Yoshida256k/maglev/リニアモーターカー仕様書.md

# リニアモーターカー仕様書

- 版：v0.3（2026-10-25）
- 用途：プレ卒業研究で製作する卓上リニアモーターカー（周回コース）の駆動システム
- コンセプト：**浮いてるミニ四駆**（永久磁石の反発で浮上し、左右の透明壁を2段ローラーでなぞって走る。車輪なし）
- 本書の使い方：本書をもとにファームウェアを作成する（生成 AI の利用を含む）。**【要確定】** の値は未決定。コードではデフォルト値で実装し、すべてパラメータ（定数または設定コマンド）として変更できるようにすること。
- CADモデル：`maglev_course.step`（生成スクリプト `maglev_course_model.py`）。寸法は本書と一致させている
- v0.3 の主な変更：
  - 車輪をやめ、永久磁石の反発で浮上する方式に変更（床に浮上磁石2列、台車に8個）
  - 内側は透明板、外側は透明シート＋透明なコイル枠。台車は前後・内外の2段ローラー（計8個）
  - 位置検出をホールセンサーの個別読み出し（74HC165）＋台車5極（S N S N S）に変更し、電源投入時から絶対位置がわかるようにした。原点センサーとホーミングを廃止し、ティーチングと位置決め制御を追加
  - ホールセンサーをユニポーラ・スイッチ型（OH44E / A3144）に指定。49E はリニア出力なので使用不可
  - 磁石の個数と費用、浮上方式の注意点を追加

---

## 0. 用語

| 用語 | 意味 |
|---|---|
| 区間（セクション） | 円周コースを等分した、個別に通電を切り替えられるコイル群の単位 |
| 母線 | インバーター出力 U・V・W をコース沿いに通した共通配線 |
| SD | ゲートドライバーのシャットダウン入力（負論理）。Low でインバーター停止 |
| m | 変調率（振幅）。0〜0.8 |
| f1 | 基本波周波数 [Hz] |
| fc | キャリア周波数 [Hz] |
| τ | 台車の駆動磁石の極ピッチ（N→S の間隔）。電気角 360° = 2τ。**中心角 4.5°（約 37.5 mm）** |
| θe | 電気角 |
| 台車位置 x | 台車の駆動磁石列「先頭」のコース上の位置。内部では中心角 [deg] または弧長 [mm] で扱う（1周 = 360° = 3000 mm） |
| セル | ホールセンサーのパターンで区別できる最小の位置単位。電気角 60° = 中心角 1.5°（約 12.5 mm） |

---

## 1. システム概要

- 方式：**地上一次式リニア同期モーター（LSM）＋永久磁石の反発による浮上**
  - 推進：外側のコイル（3相・空芯）と、台車の外側にある駆動磁石（5極）
  - 浮上：床の浮上磁石（N極上向き）と台車底面の浮上磁石（N極下向き）の反発
  - 案内：内側の透明板と外側の透明シートを、台車の2段ローラーでなぞる
- コース：**円周 3.0 m の周回コース**（コイル中心の半径 約 477.5 mm）。走行路の幅 110 mm
- 目標最高速度：**30 km/h（8.33 m/s）**。このときの基本波周波数は約 111 Hz
- **コース上のどこでも停止・発進でき、任意の位置まで運べること**
- 駆動構成：3相インバーター1台 → 母線（U・V・W）→ 区間ごとのリレー → 各区間のコイル
- 位置検出：ホールIC（ユニポーラ・スイッチ型）61個を個別に読み出し、パターンから絶対位置を求める
- 保護：ハードウェア過電流保護（SD を直接 Low）、ヒューズ、非常停止

```
 DC電源 ─ヒューズ─┬─ 3相インバーター(IGBT×6) ─ U/V/W 母線 ──┬── リレー1 ── 区間1 コイル(Y結線)
                  │        ↑ PWM, SD(共通)                  ├── ...
                  │   マイコン ←── HALL_A/B/C（ダイオードOR、割り込み）
                  │        ↑    ←── 74HC165×8（全ホールの個別読み出し、SPI）
                  │                                          └── リレー10 ── 区間10 コイル
                  └─ シャント → 増幅 → コンパレーター ──→ SD 強制Low ＋ マイコン割り込み
```

---

## 2. ハードウェア前提

### 2.1 インバーター・電源

- スイッチング素子：IGBT（各相ハーフブリッジ×3）
- ゲートドライバー：**IR2104**（IR2302 とピン互換。どちらでも可）
  - ピン配置：1:VCC、2:IN、3:/SD、4:COM、5:LO、6:VS、7:HO、8:VB
  - 1入力・デッドタイム内蔵（約 0.5 µs）。入力は 3.3 V ロジック対応
  - VCC は 15 V（IGBT のゲート電圧）
  - **IR2104 はハイサイド（VBS）の低電圧ロックアウトがない**ため、ファームウェアで次を守る
    - 起動時：SD を High にした直後、全相のローサイドを `T_BOOTSTRAP`（デフォルト 5 ms）ON にしてブートストラップを充電してから PWM を開始する
    - デューティを 100% に張り付かせない（m ≤ 0.8 なので最大 90%）
  - 出力形式を切り替えられること：`DRIVER_TYPE = IR2104 | HIN_LIN`（`IR2104` は IR2302 でも同じ）
- /SD：負論理。**全相共通で1本の GPIO（`SD_GPIO`）**に接続
  - 電源投入時・リセット時・FAULT 時は Low（停止）
  - 過電流コンパレーターと非常停止スイッチの出力も、同じ SD ラインをワイヤードORで Low にできる構成とする
- DCバス電圧 `VDC`：**24 V**（速度に余裕が欲しい場合も 30 V まで。リレー接点定格 DC 30 V、TVS 50 V の範囲内とするため）
- 電源：**絶縁された電源（市販の 24 V スイッチング電源、または絶縁トランス＋整流）**を使う
  - **スライダック＋整流は使用禁止**（単巻変圧器で商用電源と絶縁されておらず、出力が大地に対して 100 V で浮く。感電の危険があり、PC を USB 接続すると短絡する）
- DCバスに電解コンデンサー（耐圧 50 V 以上）

### 2.2 コース構造

寸法は**中心角で設計する**（部品ごとに半径が違うため、長さで揃えるとずれる）。高さは床面（ベース上面）を z = 0 とする。

| 部品 | 半径 R [mm] | 高さ z [mm] | 材料・備考 |
|---|---|---|---|
| ベース | 337〜500 | −8〜0 | 黒の板 |
| 床の浮上磁石（2列） | 392.5 と 432.5 を中心に幅 10〜12 | 0〜5 | ネオジム 20×10×5、**N極上向き**、隙間なく並べて溝に接着 |
| 内側の透明板 | 360.5〜362.5（走行面 362.5） | 0〜100 | PC または PETG を曲げて使用 |
| 外側の透明シート | 472.5〜473.5（走行面 472.5） | 0〜110 | PC 1 mm を曲げ、コイル面に密着させる |
| コイル | 473.5〜481.5 | 17〜67（中心 42） | 2.3節 |
| ホールセンサー列 | 473.5〜476.5 | 84（中心） | コイル上端から 17 mm 上。2.5節 |
| コイル枠・背板 | 481.5〜485.5 | 0〜110 | **透明**。PC 板（4 mm 程度）を曲げて使用 |
| コイル枠・上下の縁 | 473.5〜481.5 | 0〜10、102〜110 | **透明**。アクリル板のレーザーカット（平らな円弧リング） |

- コイル枠は10区間（各 36°）に分けて作る
- 遠心力は「ローラー → 外側シート → コイル → 背板」の順に伝わる。背板がたわむと磁石とコイルの隙間が広がるので、背板を厚めにするか、外側に透明アクリルの縦リブを入れる
- ホールセンサーの基板（センサー台）は透明にできないので、細い基板を透明アクリルの棚に載せる形を推奨

### 2.3 コイル・駆動磁石

- 配置：**3：4（コイル3個：磁極4個）**の集中巻。コイルは全部同じ向きに巻き、**U V W U V W …** の順に並べる
  - コイル間隔：**6°**（コイル中心の半径で約 50 mm）
  - 磁極ピッチ τ：**4.5°**（約 37.5 mm）
  - 繰り返し単位（U・V・W 1組）：18°（約 150 mm）
- コイル総数：**60個**（各相 20個）
- コイル寸法：外径 50 mm、内径 20 mm、厚さ 8 mm（空芯）
- 巻線：**UEW 0.9 mm、80回**（手巻き、占積率 約 0.5）
  - 1個あたりの線長 約 8.8 m、合計 約 530 m（予備込み 600 m、銅 約 3.4 kg）
  - 1個あたり R ≈ 0.24 Ω、L ≈ 190 µH（計算値。**巻いたら LCR メーターで実測する**）
- 巻数の根拠：24 V・m = 0.8 で使える相電圧ピーク 9.6 V に対し、30 km/h で必要な電圧が約 0.1 × N [V]（逆起電力が大部分）。N ≤ 96 のうち余裕を見て 80回
- 推力の見積もり：コイル1個あたり 200 AT（2.5 A × 80回）で約 3 N（±50%。試作で確認する）
- 駆動磁石（台車側）：ネオジム、**5極（S N S N S）、中心角 22.5°（約 187.5 mm）**
  - 1極 = 30×20×10 mm を縦に2個重ねて、幅 30 × 高さ 40 × 厚さ 10 mm 相当
  - 半径 458.5〜468.5、高さ 22〜62
  - **磁石とコイル面の隙間 5 mm**（シート内面までのすき間 4 mm ＋ シート 1 mm）
  - 両端を S 極にするのは、ホールセンサーのパターンで位置を一意に決めるため（2.5節）
  - 取付部（外側ポッド）はコースと同じ半径の円弧状にする
- **コイルを2〜3個試作して逆起電力を測ってから量産する**（6章）

### 2.4 浮上と案内

- 浮上：床の浮上磁石（N極上向き、2列）と台車底面の浮上磁石（N極下向き、20×10×5 mm を2列×4個）の反発で浮かせる
- 浮上高さ：**約 6 mm**（床磁石の上面〜台車磁石の下面）【試作で確認】
- **反発浮上は横方向と横転方向が原理的に不安定**（アーンショーの定理）。台車は常にどちらかの壁に押し付けられるので、ローラーは**常に壁を擦りながら走る**前提で設計する
- ローラー：**φ13 の2段ローラー**（ミニ四駆と同じ構成。1本の軸に上下2個）
  - 前後 × 内外 × 上下 = 8個。高さ 22〜28 と 66〜72
  - **ベアリング入り**を使う（常時接触するため）
  - ローラーと壁のすき間：片側 0.3 mm（設計値）
- 台車の質量：磁石込みで約 0.5 kg の見込み【要確定】
- 台車の高さ：約 92 mm（ホールセンサー列に合わせて外側ポッドが高くなるため）
- 床の浮上磁石は、**隙間があると走行中に上下に揺れる**ので詰めて並べる。同極どうしは強く反発するので、溝に接着剤で固定しながら並べる
- 床磁石の磁界が強いため、床面にホールセンサーは置かない

### 2.5 区間（セクション）

- 分割数 `N_SEC`：**10**
- 区間長：中心角 36°（約 300 mm）= 繰り返し単位 2組。1区間に**コイル6個（各相2個）**
- 各区間のコイルは **Y結線**。同じ相の2個は直列。中性点は区間内で閉じ、他区間と共有しない
- 1区間・1相（コイル2個直列）の定数：**R ≈ 0.48 Ω、L ≈ 0.38 mH**（実測値に置き換える）
- 区間スイッチ：**2極リレー 1個／区間**。U相とV相を開閉し、W相は常時接続
  - 接点定格：**DC 30 V・10 A 以上**（AC定格は参考にしない）
  - 駆動：ULN2803 などのトランジスタアレイ（逆起電力吸収ダイオード内蔵品）
  - 各接点間に **双方向TVS（50 V）** を接続
  - 動作時間 `T_RELAY_ON_MAX`：デフォルト 15 ms（**購入したリレーをオシロで実測した最大値に置き換える**）
  - 復帰時間 `T_RELAY_OFF_MAX`：デフォルト 5 ms（同上）
- 代替案（MOSFET による双方向スイッチ）は付録A

### 2.6 位置センサー（ホールIC）

- 種類：**ユニポーラ・スイッチ型**（S極で ON、それ以外は OFF）、**オープンコレクタ出力**
  - 推奨：**OH44E または A3144**
  - 電源は **5 V**（4.5 V 以上が必要。3.3 V では動かない）。出力のプルアップは **3.3 V** に接続する
  - **ラッチ型は使用不可**。格安品には型番どおりでない品が混じるので、届いたら全数を「S極でON・離すとOFF」で選別する
  - **49E（SS49E・OH49E）はリニア（アナログ）出力なので使用不可**
- 配置：
  - 3個1組（A・B・C）を **電気角 120° 間隔（中心角 3°、約 25 mm）** で並べる
  - 組の間隔：**中心角 18°（約 150 mm）**、20組。組の間隔は 2τ（9°）の整数倍とする
  - 高さはコイル上端から 17 mm 上（z = 84）。コイルの磁界による誤動作を避けるため
  - 台車側には、センサー列の高さに駆動磁石と同じ並び（S N S N S）の**センサー用小磁石**（10×10×5 mm）を付ける
- 必要数：**60個**（20組 × 3）＋予備
- 読み出し：
  - **個別読み出し**：60個の出力をそれぞれ **74HC165 × 8個**のデイジーチェーンに入れ、SPI で一度に読む（64 ビット）
  - **割り込み用の A・B・C**：各センサーの出力から**ショットキーダイオード（BAT54 等）経由で OR** を取り、`HALL_A`、`HALL_B`、`HALL_C` の3本にまとめる（アクティブLow）
- ノイズ対策：
  - プルアップ抵抗とRCフィルター（1 kΩ＋1 nF 程度）はマイコンの近くに置く
  - シュミットトリガー（74HC14 など）を通す
  - 信号線はインバーター・コイルの配線から離し、できればツイストペアにする

---

## 3. ファームウェア要件

### 3.1 マイコン

- 型番：【要確定】（既存の信号生成機能を拡張する）
- 必要なリソース：
  - 3相相補 PWM を出せるタイマー 1個（センターアラインド、デッドタイム挿入可能）
  - GPIO 割り込み入力 4本（`HALL_A/B/C`、`OC_FAULT_GPIO`）
  - SPI 1ch（74HC165 の読み出し用。ラッチ用 GPIO 1本）
  - リレー駆動 GPIO：10本（足りなければシフトレジスタ経由）
  - `SD_GPIO` 出力 1本
  - ADC 1ch（任意）
  - UART 1ch
  - 1 kHz の周期処理用タイマー
  - ティーチングで作った位置表を保存する Flash 領域
  - あれば：タイマーのホールセンサーインターフェース機能（エッジ時刻のハードウェアキャプチャ）

### 3.2 PWM 信号生成

- 正弦波：**256点以上のテーブル参照**（推奨 1024 点）。32 bit 位相アキュムレーター（DDS 方式）で読み出す
- 比較方式：三角波比較（センターアラインド PWM）
- デューティ：`duty = 0.5 + 0.5 × m × sin(θ)`
- 3相：U・V・W は 120° ずつ位相をずらす
- 単相：**ユニポーラ変調**（2レグ。レグ1 = +m·sin θ、レグ2 = −m·sin θ）
- デューティの更新：キャリア周期ごとの割り込み（負荷が重ければ2周期ごと）
- 起動時：ブートストラップ充電（2.1節）を行ってから PWM を開始する
- パラメータ範囲：

| パラメータ | 範囲 | 制約 |
|---|---|---|
| fc | 10〜150 kHz | IGBT 使用時は上限 `FC_MAX_IGBT = 20 kHz` |
| f1 | 1 Hz〜3 kHz | **fc ≥ 20 × f1 を満たさない設定は拒否**し、エラーを返す |
| m | 0〜0.8 | 0.8 を超える値は 0.8 に制限 |
| デッドタイム | `DEADTIME_NS`（デフォルト 1000 ns） | `HIN_LIN` モードで付加。`IR2104` モードでは IC 内蔵分（約 0.5 µs）のみ（追加も設定可） |

- 走行時の基本波周波数：f1 = v / (2τ)。30 km/h で約 111 Hz（fc = 20 kHz との比は約 180）
- 注意：fc = 150 kHz・タイマークロック 144 MHz・センターアラインドの場合、PWM 分解能は約 9 bit まで落ちる

### 3.3 V/f 制限（低周波での過電流防止）

コイルのインピーダンスから、周波数ごとの振幅上限を計算する。**停止中に制限がないと 9.6 V ÷ 0.48 Ω = 20 A 流れるので必須。**

```c
// 1区間・1相（コイル2個直列）あたりの定数（LCRメーターで実測した値に置き換える）
#define R_COIL      0.48f     // [Ω]
#define L_COIL      0.38e-3f  // [H]
#define I_COIL_MAX  2.5f      // 1区間あたりの許容ピーク電流 [A]
#define M_ABS       0.8f
// V_GAIN：3相 = VDC/2、単相ユニポーラ = VDC

float m_limit(float f) {
    float x = 2.0f * PI * f * L_COIL;
    float m = I_COIL_MAX * sqrtf(R_COIL*R_COIL + x*x) / V_GAIN;
    return (m > M_ABS) ? M_ABS : m;
}
```

- この式は逆起電力を無視しているので、走行中は安全側（実際の電流は小さくなる）
- 区間は母線に**並列**につながるので、インバーターの電流は「同時ON区間数 × 1区間の電流」になる
  - 追加条件：`N_ON × I_COIL_MAX ≤ I_INV_MAX`。満たせない場合は m をさらに下げる
- 直線的な V/f（ブースト付き）は途中で許容電流を超えるので使わない。上式をそのまま計算する
- 実行タイミング：パラメータ設定時に目標値をクリップし、1 kHz の周期処理で毎回 `m_now ≤ m_limit(f_now)` を強制する
- ランプ処理：f と m に変化率の制限をかける（`RAMP_F_HZ_PER_S`、`RAMP_M_PER_S`）
  - 周波数を下げるとき：**m を先に下げてから** f を下げる
  - 周波数を上げるとき：**f を先に上げてから** m を上げる

### 3.4 位置・速度の検出（絶対位置）

**原理**
- 台車の磁石が両端 S 極の5極なので、60個のホールセンサーの ON/OFF パターンは**コース1周のどの位置でも異なる**（セル単位 = 中心角 1.5°、約 12.5 mm で一意。計算で確認済み）
- したがって、**電源投入直後に全センサーを読めば位置がわかる**。原点センサーとホーミングは不要

**位置表（ティーチングで作る）**
- 理論値ではなく実測で作る（センサーの取り付け誤差を吸収するため）
- `TEACH` コマンドで開始。台車を手でゆっくり1周させ、74HC165 で読んだ 60 ビットのパターンと、その時点の位置カウント（A・B・C のエッジ数）を記録する
- 1周したら「パターン → セル番号（0〜239）」の表を Flash に保存する
- 表にないパターンが出たら異常とする

**走行中の位置**
- 細かい位置：`HALL_A/B/C` の両エッジで割り込みを入れ、3ビットの状態から電気角 60° 刻みの区間（0〜5）を求め、前回との差（±1）で位置カウントを増減する
  - 状態 000 と 111 は異常
  - ±1 以外の飛びは異常としてカウント（`hall_err_count`）
  - 前回のエッジから `HALL_MIN_INTERVAL_US`（デフォルト 300 µs）未満のエッジはノイズとして捨てる（30 km/h でもエッジ間隔は約 1.5 ms）
  - エッジ間は、エッジ間隔から求めた速度で補間する
- 絶対位置の照合：1 kHz の制御周期ごとに 74HC165 で全センサーを読み、表から求めたセルと位置カウントを比べる
  - 1セル以内のずれ：カウントを表の値に合わせて補正する
  - 2セル以上のずれ、または表にないパターン：FAULT
- 速度 v：直近のエッジ間隔から計算。`T_HALL_TIMEOUT`（デフォルト 200 ms）エッジがなければ v = 0
- 状態表（3ビット → 区間）の並びは、センサーの取り付け順と磁石の向きで変わる。ティーチング時に実測の順番から決める

**故障の検出**
- `hall_err_count` が `HALL_ERR_MAX`（デフォルト 10 回 / 1 秒）を超えたら FAULT
- `HALLDIAG` コマンド：全センサーの ON/OFF を一覧表示する（どのセンサーが壊れたかの特定用）

### 3.5 駆動モード

| モード | 内容 | 用途 |
|---|---|---|
| `OPENLOOP_VF` | f1 の指令から電気角を積分し、V/f 制限付きで出力 | 試験、低速 |
| `HALL_SYNC` | ホール信号で電気角を補正して出力（ブラシレスDCモーターと同じ原理） | **本番の走行** |
| `SINGLE_PHASE` | 単相ユニポーラ、正弦波 | パワースピーカー等の試験 |
| `AUDIO` | 単相ユニポーラ、音声データを変調波にする | パワースピーカー |

`HALL_SYNC` の詳細：
- 出力電圧の位相 = θe ＋ `THETA_OFFSET` ＋ `THETA_LEAD`
  - `THETA_OFFSET`：設置後に校正する（デフォルト 90°）
  - `THETA_LEAD`：速度に応じた進角（デフォルト 0°）
- 低速（エッジ間隔 > `T_HALL_TIMEOUT`）では補間せず、その 60° 区間の中央の角度を使う
- 推力は m で指令する（V/f 制限と電流制限の範囲内）
- 発進：静止時は現在のホール状態から位相を決め、m を 0 から徐々に上げる
- 速度制御：目標速度 `v_ref` に対して PI 制御で m を決める
- 走行方向：`DIR = FWD | REV`

### 3.6 位置決め（任意の位置まで運ぶ）

- `GOTO <位置 mm>` で目標位置を指定する。進む方向は近いほう（`DIR` 指定があればそれに従う）
- 速度の指令は台形パターン（加速 → 一定速 → 減速）。加速度 `ACC_MAX`、最高速度 `V_MAX` で作る
- 最後は位置の偏差に対する PI 制御で止める。停止精度の目標：±5 mm 程度
- 停止後の保持：
  - 位置偏差が `POS_TOL` 以内に `T_SETTLE` 続いたら到着とする
  - **保持には電流が必要で、1区間あたり約 4.5 W 発熱する**。`HOLD_TIMEOUT`（デフォルト 2 s）を過ぎたら SD を Low にし、ローラーの摩擦で止めておく
- 周回中の目標（同じ場所を何周か後に通る）も扱えるよう、目標は「周回数＋位置」で持てるようにする

### 3.7 区間切り替え

- 台車が占める範囲：`[x − L_CART, x]`（`DIR = REV` のときは前後を反転）
- 先読み距離：`D_LOOKAHEAD = |v| × (T_RELAY_ON_MAX + T_MARGIN)`（`T_MARGIN` デフォルト 5 ms）
- 後方の余裕：`D_RELEASE = |v| × T_RELAY_OFF_MAX`
- **ONにする区間**：範囲 `[x − L_CART − D_RELEASE, x + D_LOOKAHEAD]` に少しでもかかる区間すべて
- **OFFにする区間**：上の範囲から外れた区間
- 停止中：台車がかかっている区間をすべて ON にする
- 同時ON区間数の上限 `N_ON_MAX`（デフォルト 3）。超える場合は速度指令を制限する

切り替え方式は速度によって変える。

- **低速モード**（`|v| < V_HOTSWITCH`、デフォルト 1.0 m/s【調整】）：**無電流で切り替える**
  1. SD を Low にする
  2. コイル電流の減衰を待つ：`T_DECAY = 5 × L_COIL / R_COIL`（デフォルト 4 ms）
  3. リレーを切り替える
  4. ON 動作なら `T_RELAY_ON_MAX`、OFF 動作なら `T_RELAY_OFF_MAX` 待つ
  5. FAULT でなければ SD を High に戻す
- **高速モード**（`|v| ≥ V_HOTSWITCH`）：インバーターを止めずに切り替える
  - ON：先読みしているので、台車が来る前にコイルに通電した状態で ON する（電流ゼロから立ち上がるため無害）
  - OFF：通電したまま切る。サージは接点間の TVS に吸収させる

### 3.8 単相・オーディオモード

- 変調方式：単相ユニポーラ
- 音声データ：形式【要確定：WAV、サンプリング周波数、ビット数、長さ】、保存先【要確定：内蔵Flash／SDカード】
- **直流成分の除去とハイパスフィルター（30 Hz 程度）は必須**（スピーカーに直流が流れ続けると焼損する）
- 振幅は 0.8 でクリップする
- キャリア周波数：IGBT では上限 20 kHz（再生帯域は数 kHz 程度が限界）。音質を求める場合は MOSFET 基板で 50 kHz 以上
- 単相モードでは V/f 制限は使わない

### 3.9 状態遷移

```
BOOT → IDLE → READY → RUN / GOTO → STOPPING → READY
               ↑ ↓
              TEACH
                         ↘ どの状態からでも → FAULT → (RESETコマンド) → IDLE
```

| 状態 | 動作 |
|---|---|
| BOOT | 周辺機能の初期化。SD = Low、全リレー OFF。Flash から位置表を読む |
| IDLE | SD = Low。設定コマンドを受け付ける。全センサーを読んで位置を求め、求まれば READY へ |
| TEACH | 位置表を作る（3.4節）。SD = Low のまま、台車を手で1周させる |
| READY | 位置確定済み、停止中。m = 0 |
| RUN | 速度指令で走行（3.5節・3.7節）。SD を High にする前にブートストラップ充電を行う |
| GOTO | 位置決め（3.6節） |
| STOPPING | ランプで減速し、v = 0 になったら READY |
| FAULT | SD = Low をラッチ。`T_DECAY` 経過後に全リレーを OFF。原因を記録 |

- 位置表がない、または電源投入時のパターンが表にない場合は IDLE に留まり、`TEACH` を促すメッセージを出す

FAULT の要因：
- 過電流割り込み（`OC_FAULT_GPIO`）
- ホール状態の異常（3.4節）、絶対位置の照合エラー
- 脱調・停止の検出：RUN 中、指令速度 > 0 なのに `T_HALL_TIMEOUT` の間エッジがない
- 位置不定のまま RUN / GOTO が指令された
- 設定値の範囲外
- ウォッチドッグタイムアウト

**FAULT は自動では解除しない。** RESET コマンドでのみ IDLE に戻る。

### 3.10 処理周期

| 処理 | 周期 | 内容 |
|---|---|---|
| PWM 割り込み | キャリア周期 | 位相を進め、テーブルを引き、デューティを更新 |
| ホール割り込み | エッジごと | 位置カウント、エッジ時刻の記録、電気角の補正 |
| 制御周期 | 1 kHz | 全センサーの読み出しと絶対位置の照合、ランプ、V/f 制限、速度・位置制御、区間切り替えの判定、FAULT 判定 |
| 通信 | メインループ | UART コマンドの処理 |

### 3.11 コマンド（UART、115200 bps、ASCII、改行で終端）

| コマンド | 内容 |
|---|---|
| `MODE OPENLOOP_VF\|HALL_SYNC\|SINGLE_PHASE\|AUDIO` | 駆動モードの選択（IDLE / READY 時のみ） |
| `FC <Hz>` | キャリア周波数 |
| `F1 <Hz>` | 基本波周波数（`OPENLOOP_VF` / `SINGLE_PHASE`） |
| `M <0.0-0.8>` | 変調率の指令 |
| `SPEED <km/h>` | 目標速度（`HALL_SYNC`） |
| `DIR FWD\|REV` | 走行方向 |
| `GOTO <mm>` | 指定位置まで運んで止める |
| `RUN` / `STOP` | 走行開始 / 減速停止 |
| `ESTOP` | 即時停止（SD = Low、FAULT へ） |
| `RESET` | FAULT の解除 |
| `TEACH` | 位置表の作成を開始（台車を手で1周させる） |
| `HALLDIAG` | 全ホールセンサーの ON/OFF を表示 |
| `SET <名前> <値>` / `GET <名前>` | パラメータの設定 / 取得 |
| `STATUS` | 状態、位置、速度、f1、m、ON 区間、FAULT 要因、電流（ADC がある場合） |

応答：成功時は `OK`、失敗時は `ERR <理由>`。

### 3.12 パラメータ一覧

| 名前 | デフォルト | 単位 | 備考 |
|---|---|---|---|
| `DRIVER_TYPE` | IR2104 | – | IR2104（IR2302 も同じ）/ HIN_LIN |
| `VDC` | 24 | V | 30 V まで |
| `N_SEC` | 10 | – | 1区間 = コイル6個 |
| `N_COIL` | 60 | – | 各相 20個 |
| `COIL_PITCH_DEG` | 6.0 | deg | 約 50 mm |
| `TAU_DEG` | 4.5 | deg | 約 37.5 mm |
| `N_POLE_CART` | 5 | – | S N S N S |
| `L_CART` | 187.5 | mm | 駆動磁石列の長さ（中心角 22.5°） |
| `N_HALL` | 60 | – | 20組 × 3 |
| `R_COIL` | 0.48 | Ω | 1区間・1相（2個直列）。実測値に置き換える |
| `L_COIL` | 0.38 | mH | 同上 |
| `I_COIL_MAX` | 2.5 | A（ピーク） | 200 AT 相当 |
| `I_INV_MAX` | 10.0 | A（ピーク） | インバーターの許容電流【要確定】 |
| `FC` | 20 | kHz | IGBT 使用時の上限 20 kHz |
| `FC_MAX_IGBT` | 20 | kHz | |
| `DEADTIME_NS` | 1000 | ns | `HIN_LIN` モード用 |
| `T_BOOTSTRAP` | 5 | ms | 起動時のローサイド ON 時間 |
| `M_ABS` | 0.8 | – | 絶対上限 |
| `RAMP_F_HZ_PER_S` | 50 | Hz/s | 【調整】 |
| `RAMP_M_PER_S` | 0.5 | 1/s | 【調整】 |
| `V_MAX` | 8.33 | m/s | 30 km/h |
| `ACC_MAX` | 3.0 | m/s² | 【調整】 |
| `POS_TOL` | 5 | mm | 到着判定 |
| `T_SETTLE` | 200 | ms | 到着判定 |
| `HOLD_TIMEOUT` | 2000 | ms | 保持をやめて SD を Low にするまでの時間 |
| `T_RELAY_ON_MAX` | 15 | ms | 実測値に置き換える |
| `T_RELAY_OFF_MAX` | 5 | ms | 実測値に置き換える |
| `T_MARGIN` | 5 | ms | |
| `T_DECAY` | 4 | ms | 5 × L/R |
| `V_HOTSWITCH` | 1.0 | m/s | 【調整】 |
| `N_ON_MAX` | 3 | – | |
| `T_HALL_TIMEOUT` | 200 | ms | |
| `HALL_MIN_INTERVAL_US` | 300 | µs | これより短いエッジはノイズとして捨てる |
| `HALL_ERR_MAX` | 10 | 回/s | 超えたら FAULT |
| `THETA_OFFSET` | 90 | deg | 校正する |
| `THETA_LEAD` | 0 | deg | |

---

## 4. 消費電力の見積もり

前提：2.3節の巻線（コイル1個 0.24 Ω）、1区間あたり 2.5 A ピーク（200 AT）。

- 1区間の発熱：6個 × 0.24 Ω × (2.5 / √2)² ≈ **4.5 W**
- 30 km/h 走行時の通電範囲：台車 18.75 cm ＋先読み 12.5 cm ＋復帰待ち 4 cm ≈ 35 cm → 区間長 30 cm なので**最大 3区間 ON**

| 状態 | 同時ON区間数 | コイル発熱 | インバーター電流（ピーク） |
|---|---|---|---|
| 停止中・低速 | 1〜2 | 約 4.5〜9 W | 2.5〜5 A |
| 30 km/h 走行 | 最大 3 | 約 13.5 W | 7.5 A |
| 全区間 ON（試験のみ） | 10 | 約 45 W | 25 A |

- 台車を走らせるのに実際に必要な電力は数 W 程度。消費電力のほとんどはコイルの発熱
- 浮上自体には電力を使わない（永久磁石）
- コイル発熱は電圧ではなく巻き枠の銅の量で決まる（48 V にしても減らない）

---

## 5. 安全要件

- **遠心力**：半径約 0.47 m を 30 km/h で走ると、横方向の加速度は約 146 m/s²（約 15 G）。台車 0.5 kg なら約 73 N で外側の壁を押す。外側シート・コイル・背板・ローラーはこれに耐える設計にする
- **防護囲いを必ず設ける**（外側の透明壁とは別に、上面からの飛び出しも防ぐ）。秒速 8 m で台車が飛び出すと観客が怪我をする恐れがある
- **電源は絶縁されたものを使う。スライダック＋整流は禁止**（2.1節）
- **強力なネオジム磁石の取り扱い**：床の浮上磁石約 260 個は同極どうしで強く反発する。指を挟まないよう治具を使い、1個ずつ溝に接着する。磁石の近くに工具や鉄部品を置かない
- 電源投入時・リセット時は SD = Low、全リレー OFF
- 過電流保護はハードウェアで SD を直接 Low にする（ソフトに依存しない）
- 非常停止スイッチで SD を直接 Low
- DCバスにヒューズ
- FAULT は自動で復帰させない
- 展示中はコイルの温度を確認する（全区間ON での連続運転はしない）

---

## 6. 試験項目

**量産前の試作（この順番で行う）**
1. **浮上試験**：床磁石を 20 cm 分（約 20 個）並べ、台車の底板（浮上磁石8個＋想定重量のおもり）を載せて、約 6 mm 浮くこと、ローラーで横を押さえれば安定することを確認する
2. **コイル試作**：2〜3個巻いて R・L を実測する。台車の磁石を一定速度で動かして逆起電力を測り、30 km/h 換算で1個あたり約 7 V ピークになるか確認する。大きければ巻数を減らし、小さければ増やす
3. **ホールセンサーの選別と誤動作試験**：全数を磁石で選別する。台車なしで1区間に最大電流（2.5 A）を 1〜200 Hz で流し、センサーが1つも反応しないことを確認する

**組み立て後**
4. PWM 波形：3相の 120° 位相差、デッドタイム、m = 0.8 で制限されること、fc < 20 × f1 の設定が拒否されること
5. SD：起動直後に Low であること、`ESTOP`・過電流・非常停止で即座に Low になること
6. ブートストラップ：起動直後からハイサイドのゲート電圧が 12 V 以上出ていること
7. 過電流保護：シャントに模擬電流を流し、コンパレーターが動作し SD が Low になること。FAULT が自動で解除されないこと
8. V/f 制限：低周波で m が `m_limit(f)` を超えないこと、周波数を急に下げてもランプの順序が守られること
9. リレー：動作時間・復帰時間を実測し、パラメータに反映すること
10. ティーチングと絶対位置：`TEACH` で表を作り、電源を入れ直してもコース上のどこに置いても正しい位置が出ること。`HALLDIAG` で全センサーが読めること
11. 区間切り替え：低速では無電流切り替えになること、高速では先読みで ON されること、境目で停止しても発進できること
12. 走行：`OPENLOOP_VF` の低速 → `HALL_SYNC` での加速の順に段階的に確認する。`THETA_OFFSET` を校正する
13. 位置決め：`GOTO` で数か所に運び、停止位置のずれが ±5 mm 程度に収まること
14. 温度：10 分間連続運転し、コイル・IGBT・リレー・ローラーの温度上昇を確認する

---

## 7. 未決定事項

- マイコンの型番
- 台車の重さ（浮上試験の結果で浮上磁石の数・厚さを見直す）
- コイルの R・L（実測）と逆起電力（試作で確認）
- インバーターの許容電流
- リレーの型番と実測の動作時間
- 音声データの形式と保存先

---

## 8. 磁石の個数と費用

| 磁石 | 用途 | 個数（予備込み） | 単価の目安 | 小計 |
|---|---|---|---|---|
| 20×10×5 mm | 床の浮上磁石（2列、約 5.2 m）＋台車の浮上磁石 8個 | 約 290 個 | 40〜70 円 | 約 1.2万〜2万円 |
| 30×20×10 mm | 駆動磁石（1極 2個 × 5極） | 12 個 | 200〜500 円 | 約 2,400〜6,000 円 |
| 10×10×5 mm | センサー用小磁石 | 10 個 | 15〜30 円 | 約 300 円 |
| **合計** | | | | **約 1.5万〜2.7万円** |

- AliExpress・N35 グレードを想定（1ドル 150 円換算、2026年10月時点の目安）。浮上用は N35 で十分
- 費用の約 8 割が床の浮上磁石。**最初に 20 個程度だけ買って浮上試験をしてから残りを買う**
- 台車を軽くできれば、床磁石を薄い 20×10×3 mm にして費用を下げられる

---

## 付録A：MOSFET による区間スイッチ（代替案）

リレーの接点寿命や動作時間が問題になった場合の代替案。

- 構成：Nch MOSFET 2個のソース同士を接続した双方向スイッチ。ゲートはソースの中点を基準に駆動する
- MOSFET：**TK6R7A10PL**（秋月、100 V・56 A、4.5 V 駆動でオン抵抗規定、TO-220SIS 絶縁型）
- ゲート駆動：**VOM1271**（光起電力型 MOSFET ドライバー、外部電源不要、開放電圧 約 8 V）
  - LED 電流 10 mA（3.3 V 駆動で 180 Ω）
  - ON までに数 ms かかるため、ON 後 20 ms 待ってから通電する
  - **PWM のゲートドライバーとしては使用不可**（出力電流が µA 級のため）
- 個数：1区間あたり MOSFET 4個、VOM1271 2個
- 保護：ドレイン間に双方向 TVS

## 付録B：位置検出の代替案（不採用）

- **49E（リニア）＋アナログマルチプレクサ**：補間でサブ mm の精度が出るが、3 m のアナログ配線がコイルの PWM のすぐ横を通るためノイズ対策と校正の負担が大きい。方式Aで精度が足りない場合の次の手段
- **中心軸＋アーム＋磁気エンコーダー**：最も簡単・高精度だが、コース上にアームが見えるため不採用
- **台車に IMU・エンコーダーを積む**：積分のずれ、無線の遅れ、台車の電源が必要なため不採用

## 付録C：部品メモ

- ゲートドライバー：IR2104 × 3（予備込みで多めに）
- 巻線：UEW 0.9 mm × 600 m（約 3.4 kg）
- 磁石：8章のとおり
- ホールIC：OH44E または A3144（ユニポーラ・スイッチ型）× 60 ＋予備（100個入りを買って選別）
- 74HC165 × 8、74HC14（シュミットトリガー）、ショットキーダイオード（BAT54 等）× 60
- ローラー：φ13 ベアリング入り × 8 ＋予備
- 透明材：外側シート PC 1 mm、内側板 PC/PETG、コイル枠の背板 PC 4 mm 程度、上下の縁 アクリル（レーザーカット）
- リレー：2極、接点 DC 30 V・10 A 以上 × 10 ＋予備
- リレー駆動：ULN2803
- TVS：双方向 50 V × 20（リレー接点 2個 × 10区間）
- シャント：10 A / 75 mV 分流器（全区間ON 試験用は 30 A / 75 mV）
- オペアンプ：レールtoレール出力
- コンパレーター：LM393
- 電源：24 V スイッチング電源（絶縁型）、ホールセンサー用 5 V
- ヒューズ＋ホルダー
- IGBT・ゲートドライバーの予備
- 0.1 µF パスコン（各 IC・センサーに）
