Yoshida256k/maglev/ハードウェア設計/インバータの回路図.jpg

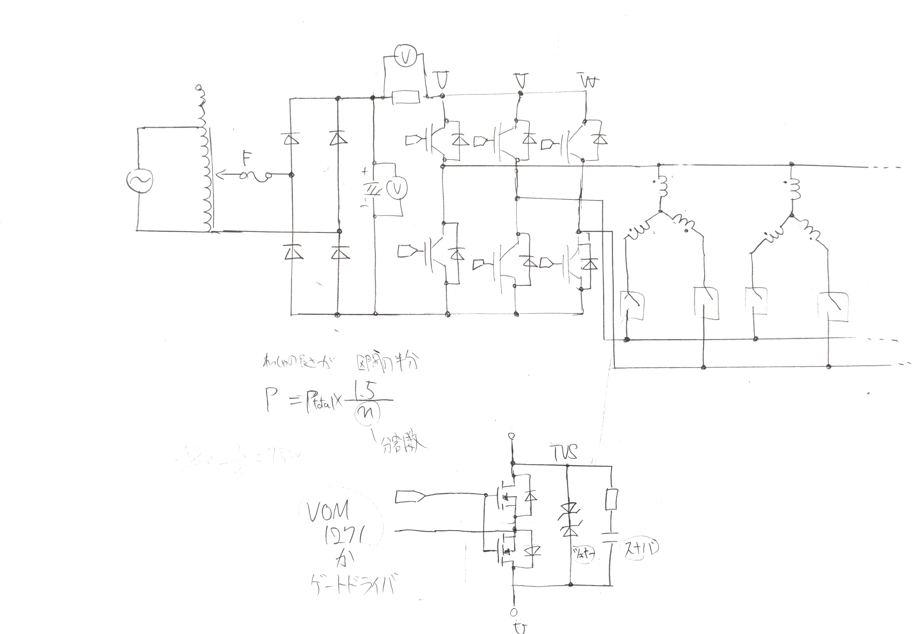
ハードウェア設計/インバータの回路図.jpg
