Yoshida256k/maglev/ハードウェア設計/比較資料_生成元/images/f_cart_3q.png

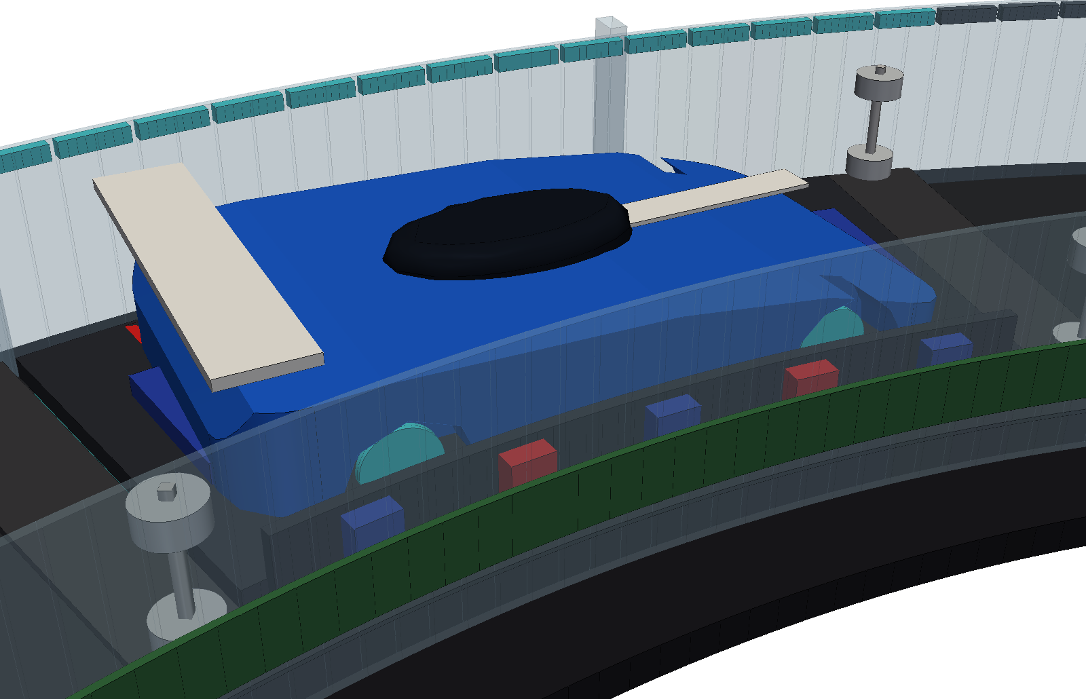
ハードウェア設計/比較資料_生成元/images/f_cart_3q.png
