Yoshida256k/maglev/ハードウェア設計/比較資料_生成元/images/m_overall.png

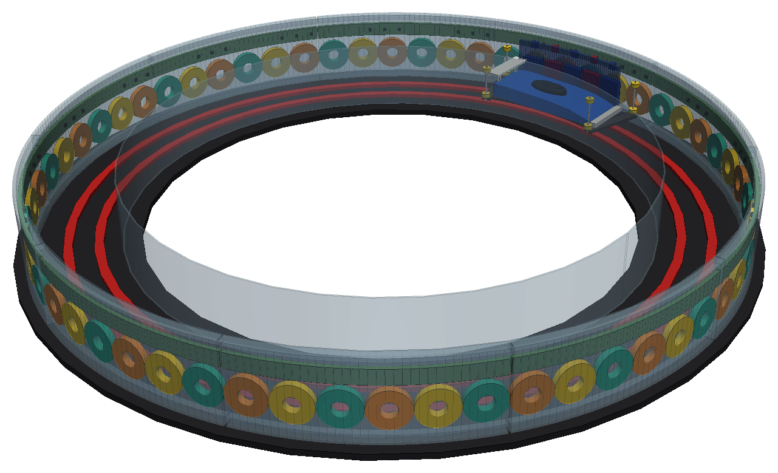
ハードウェア設計/比較資料_生成元/images/m_overall.png
