Yoshida256k/maglev/ハードウェア設計/比較資料_生成元/images/m_section.png

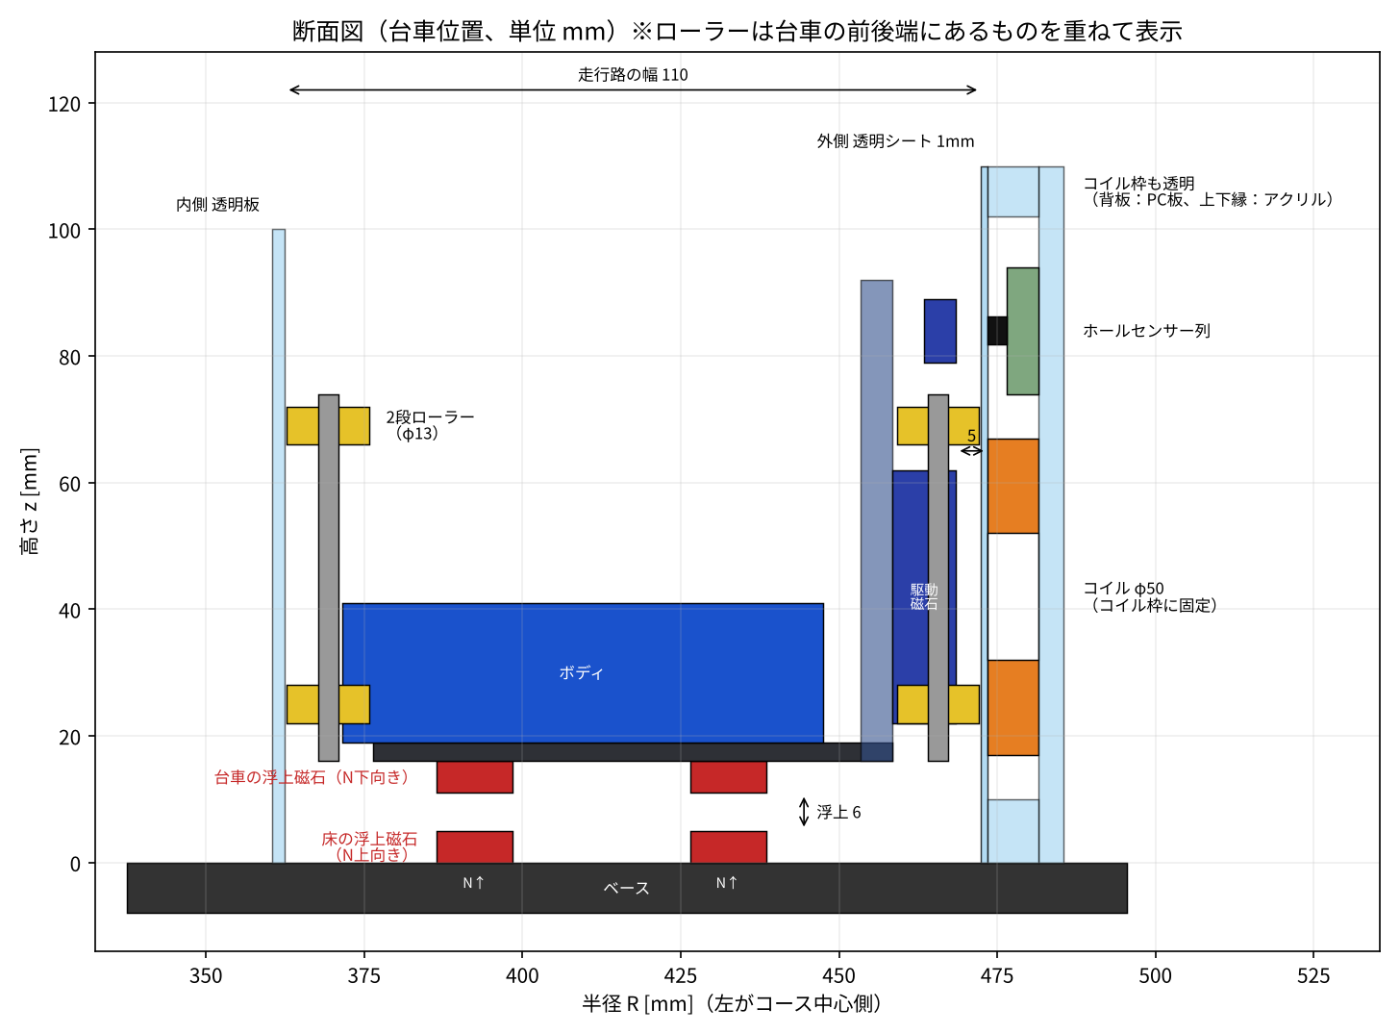
ハードウェア設計/比較資料_生成元/images/m_section.png
