Yoshida256k/maglev/ハードウェア設計/第一案/m_cart_close.png

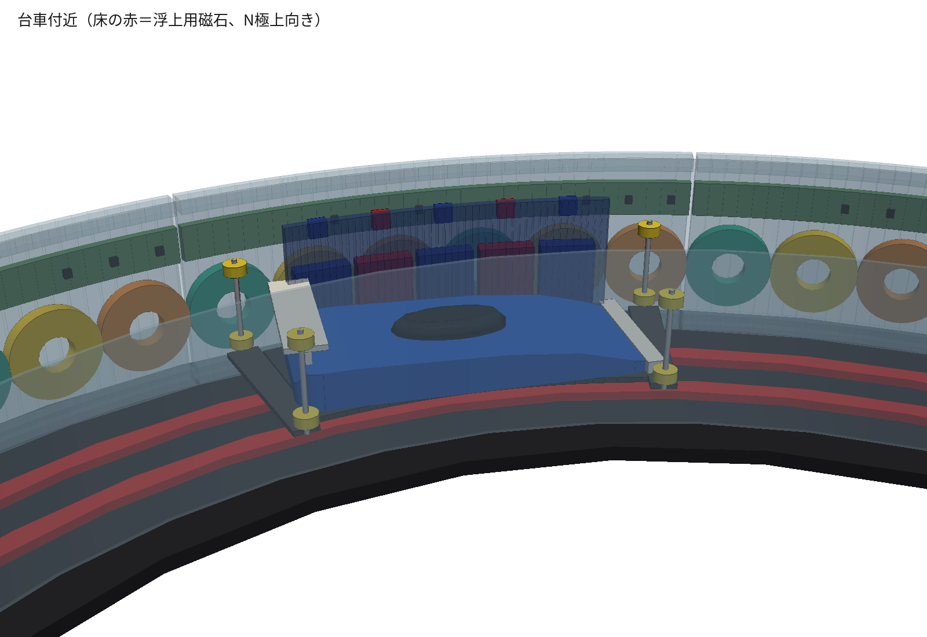
ハードウェア設計/第一案/m_cart_close.png
