Yoshida256k/maglev/ハードウェア設計/第一案/m_cart_only.png

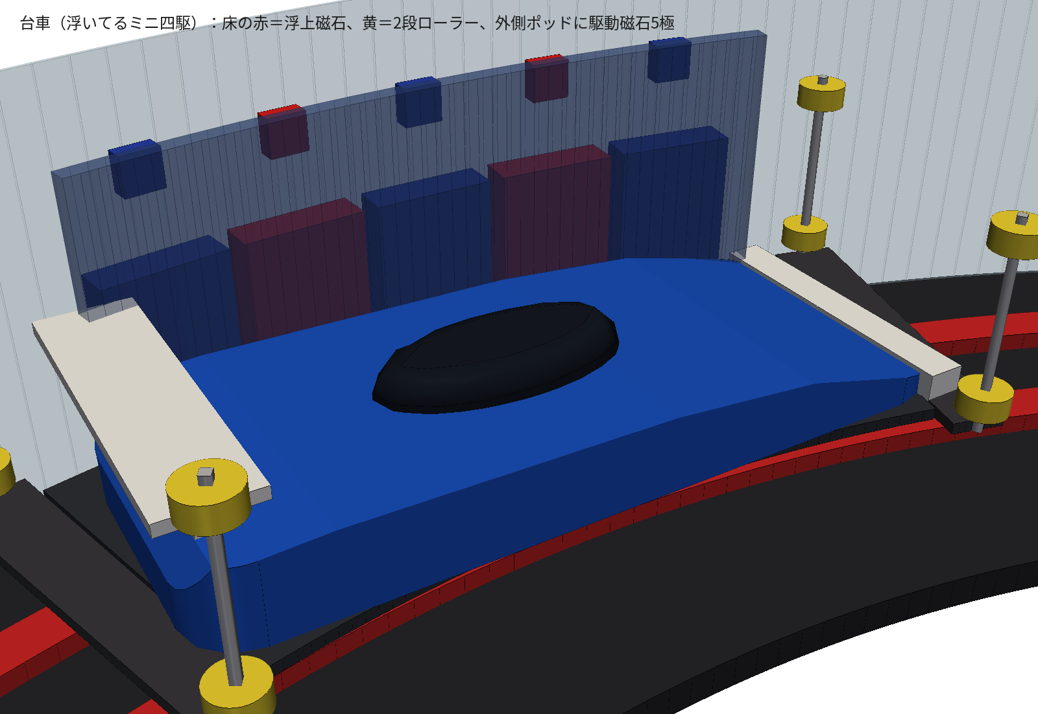
ハードウェア設計/第一案/m_cart_only.png
