Yoshida256k/maglev/ハードウェア設計/第一案/m_section.png

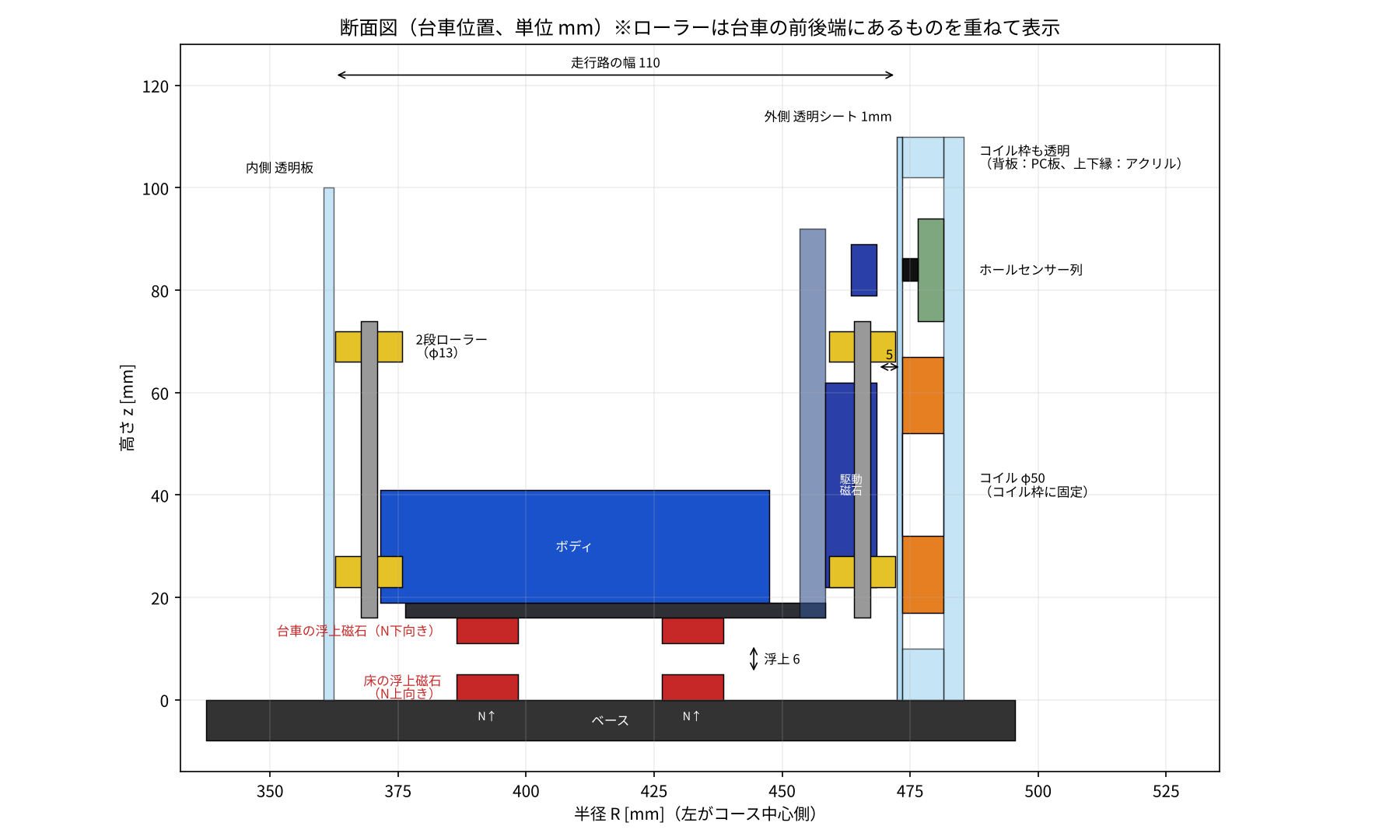
ハードウェア設計/第一案/m_section.png
