Yoshida256k/maglev/ハードウェア設計/第二案/f_cart_3q.png

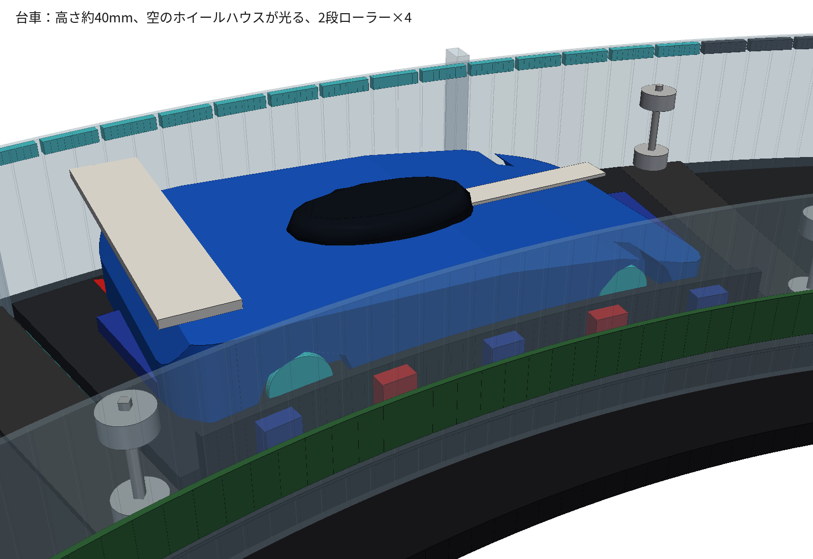
ハードウェア設計/第二案/f_cart_3q.png
