Yoshida256k/maglev/ハードウェア設計/第二案/f_eye_level.png

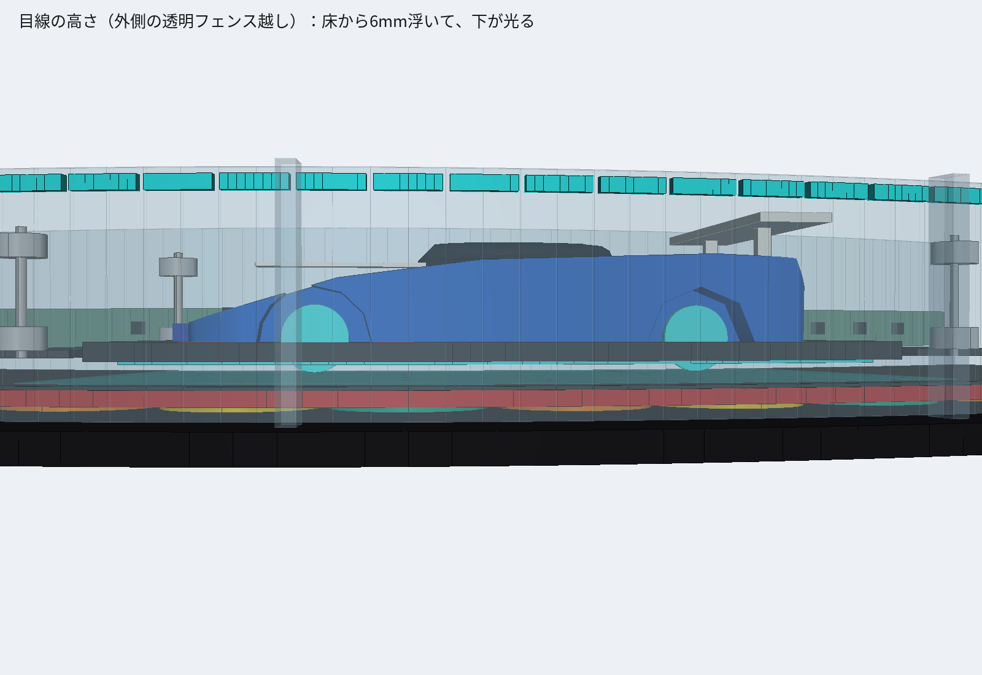
ハードウェア設計/第二案/f_eye_level.png
