Yoshida256k/maglev/ハードウェア設計/第二案/f_overall_inside.png

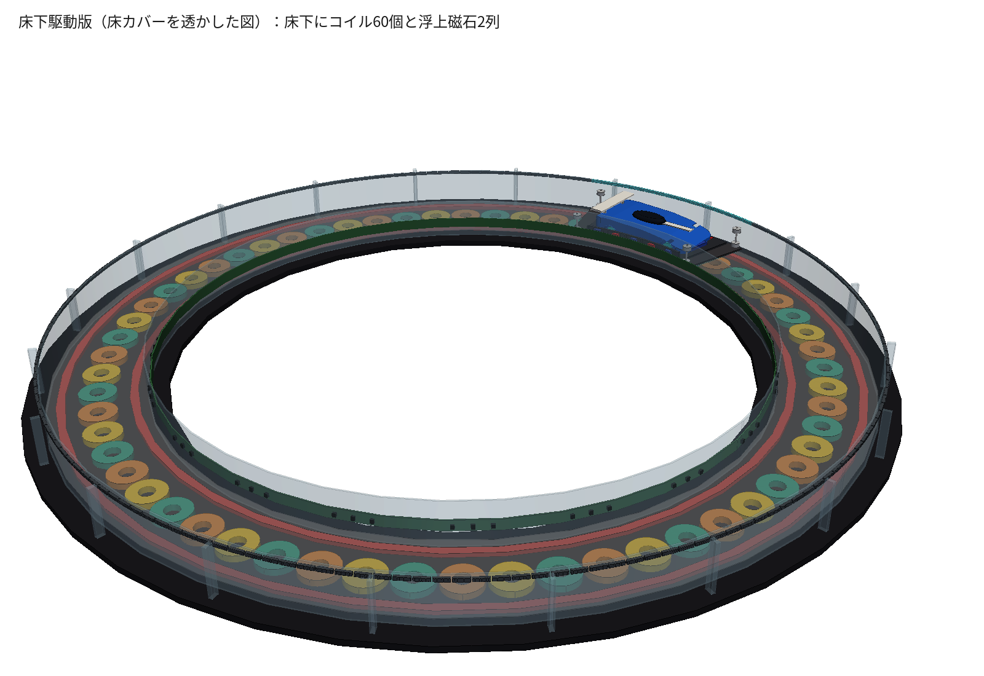
ハードウェア設計/第二案/f_overall_inside.png
