Yoshida256k/maglev/ハードウェア設計/第二案/f_section.png

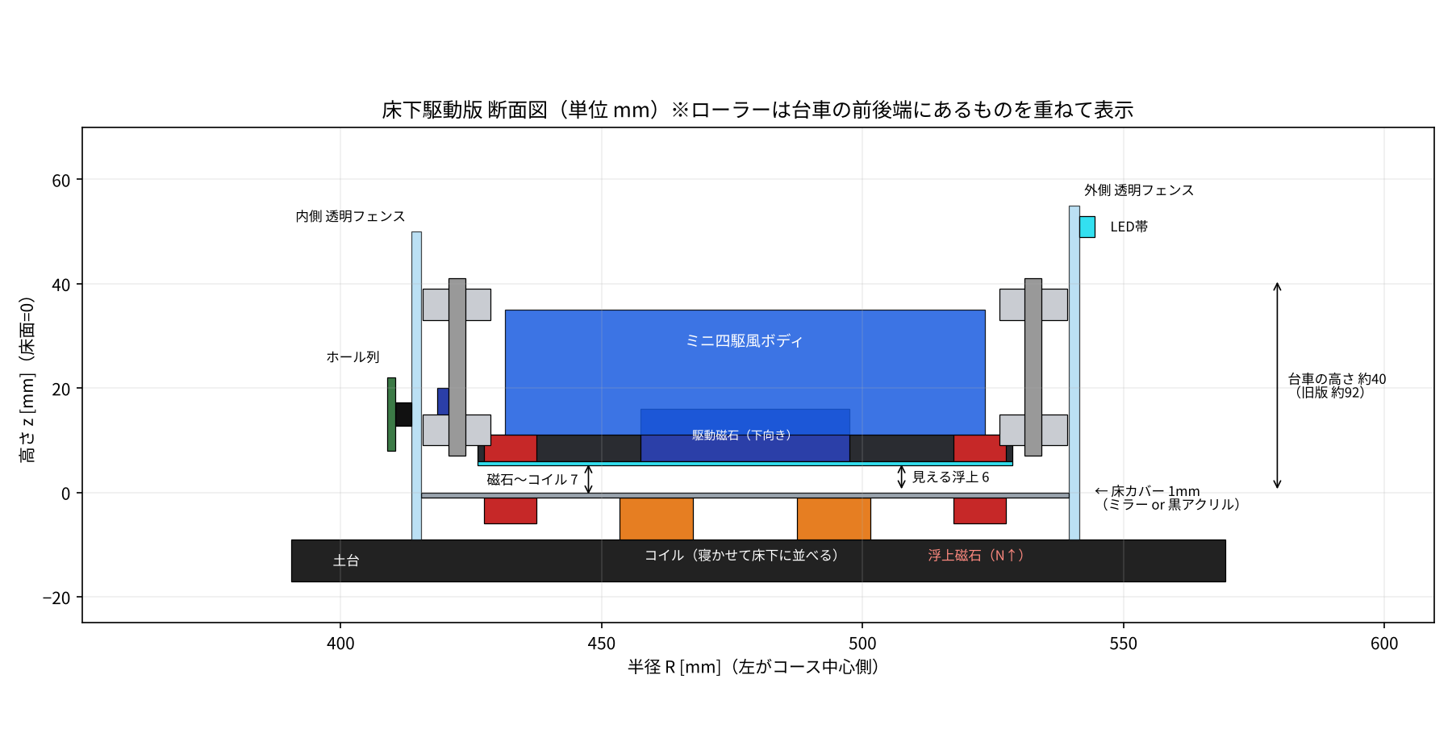
ハードウェア設計/第二案/f_section.png
