Yoshida256k/maglev/ハードウェア設計/第一案/maglev_course.step

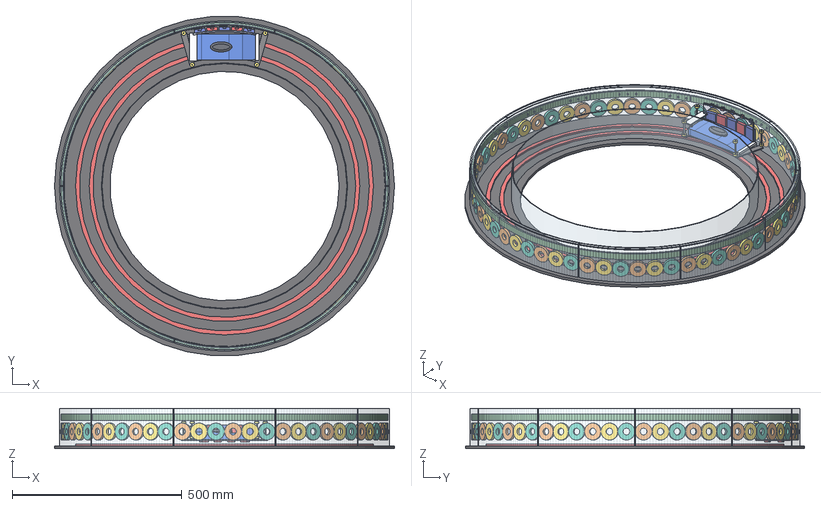
[picture p22: CAD file, 2026-10-26]
ハードウェア設計/第一案/maglev_course.step
1000.9 x 998.1 x 118.0 mm
base
lev_floor_row0
lev_floor_row1
inner_clear_wall
outer_clear_sheet
coil_frame_back_sec01
coil_frame_rims_sec01
sensor_rail_sec01
coil_frame_back_sec02
coil_frame_rims_sec02
sensor_rail_sec02
coil_frame_back_sec03
coil_frame_rims_sec03
sensor_rail_sec03
coil_frame_back_sec04
coil_frame_rims_sec04
sensor_rail_sec04
coil_frame_back_sec05
coil_frame_rims_sec05
sensor_rail_sec05
coil_frame_back_sec06
coil_frame_rims_sec06
sensor_rail_sec06
coil_frame_back_sec07
coil_frame_rims_sec07
sensor_rail_sec07
coil_frame_back_sec08
coil_frame_rims_sec08
sensor_rail_sec08
coil_frame_back_sec09
coil_frame_rims_sec09
sensor_rail_sec09
coil_frame_back_sec10
coil_frame_rims_sec10
sensor_rail_sec10
coil_00_U
coil_01_V
coil_02_W
coil_03_U
coil_04_V
coil_05_W
coil_06_U
coil_07_V
coil_08_W
coil_09_U
coil_10_V
coil_11_W
coil_12_U
coil_13_V
coil_14_W
coil_15_U
coil_16_V
coil_17_W
coil_18_U
coil_19_V
coil_20_W
coil_21_U
coil_22_V
coil_23_W
coil_24_U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
