Yoshida256k/maglev/ハードウェア設計/第二案/maglev_floor_drive.step

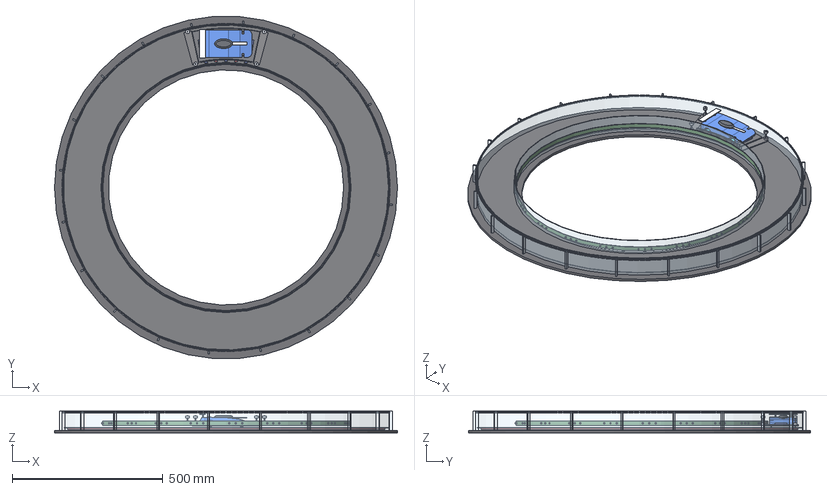
[picture p23: CAD file, 2026-10-26]
ハードウェア設計/第二案/maglev_floor_drive.step
1138.9 x 1135.7 x 72.0 mm
base
coil_00_U
coil_01_V
coil_02_W
coil_03_U
coil_04_V
coil_05_W
coil_06_U
coil_07_V
coil_08_W
coil_09_U
coil_10_V
coil_11_W
coil_12_U
coil_13_V
coil_14_W
coil_15_U
coil_16_V
coil_17_W
coil_18_U
coil_19_V
coil_20_W
coil_21_U
coil_22_V
coil_23_W
coil_24_U
coil_25_V
coil_26_W
coil_27_U
coil_28_V
coil_29_W
coil_30_U
coil_31_V
coil_32_W
coil_33_U
coil_34_V
coil_35_W
coil_36_U
coil_37_V
coil_38_W
coil_39_U
coil_40_V
coil_41_W
coil_42_U
coil_43_V
coil_44_W
coil_45_U
coil_46_V
coil_47_W
coil_48_U
coil_49_V
coil_50_W
coil_51_U
coil_52_V
coil_53_W
coil_54_U
coil_55_V
coil_56_W
coil_57_U
coil_58_V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
