Yoshida256k/maglev/ハードウェア設計/旧案_車輪あり/linear_course.step

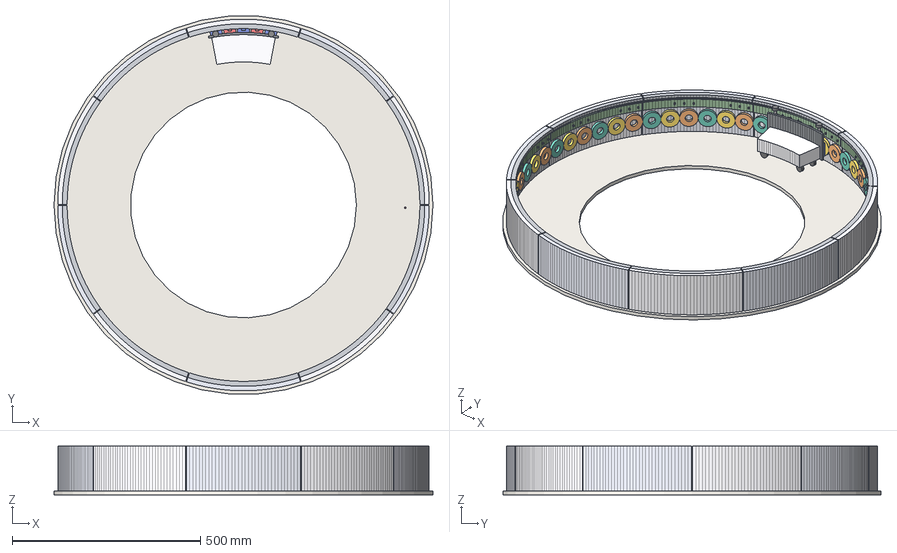
[picture p24: CAD file, 2026-10-26, an earlier design]
ハードウェア設計/旧案_車輪あり/linear_course.step
1006.9 x 1004.1 x 130.0 mm
floor
wall_sec01
sensor_rail_sec01
guide_rail_sec01
wall_sec02
sensor_rail_sec02
guide_rail_sec02
wall_sec03
sensor_rail_sec03
guide_rail_sec03
wall_sec04
sensor_rail_sec04
guide_rail_sec04
wall_sec05
sensor_rail_sec05
guide_rail_sec05
wall_sec06
sensor_rail_sec06
guide_rail_sec06
wall_sec07
sensor_rail_sec07
guide_rail_sec07
wall_sec08
sensor_rail_sec08
guide_rail_sec08
wall_sec09
sensor_rail_sec09
guide_rail_sec09
wall_sec10
sensor_rail_sec10
guide_rail_sec10
coil_00_U
coil_01_V
coil_02_W
coil_03_U
coil_04_V
coil_05_W
coil_06_U
coil_07_V
coil_08_W
coil_09_U
coil_10_V
coil_11_W
coil_12_U
coil_13_V
coil_14_W
coil_15_U
coil_16_V
coil_17_W
coil_18_U
coil_19_V
coil_20_W
coil_21_U
coil_22_V
coil_23_W
coil_24_U
coil_25_V
coil_26_W
coil_27_U
coil_28_V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
