Yoshida256k/maglev/(commit log)

2026-10-26 仕様書・CAD・設計資料を追加（浮いてるミニ四駆）
    - リニアモーターカー仕様書 v0.3（要求仕様）
    - ソフトウェア設計：現行ソフトウェア仕様書、ホール配置の一意性チェック
    - ハードウェア設計：インバータ回路図、第一案（側面駆動）・第二案（床下駆動）・旧案の
    CadQuery モデル、STEP、描画・断面・干渉チェックのスクリプト、比較PDFと生成スクリプト
    - README：概要、案の比較、図とSTEPの作り直し方
    Claude-Session: https://claude.ai/code/session_01Lwxk5JwDntjiFn3rYZsffR
    [linear_course.step, maglev_course.step, maglev_floor_drive.step]
2026-10-27 仕様書と README のリンクを maglev 内の picofunc に合わせる
    - 現行ソフトウェア仕様書: GitHub のリンクを ソフトウェア設計/picofunc/ に変更、要求仕様へのリンクを ../ に修正、v0.3 への注記を追加
    - README: フォルダ構成に picofunc/ を追加、関連に操作アプリ (PWA) の URL を追加
2026-10-28 資料の言い回しを整える（くだけた表現・略語を改める）
    Claude-Session: https://claude.ai/code/session_01VxHBLGdy5Por26E8bFEEcZ
